lwaken/LwaCoin/3D/ANIM3_Moment.jpg

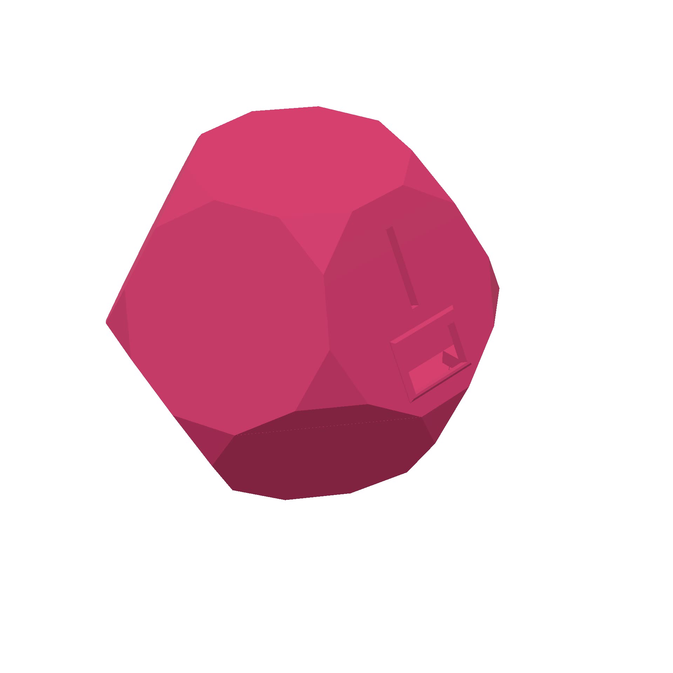
3D/ANIM3_Moment.jpg
