lwaken/LwaCoin/3D/atsdftgyh.png

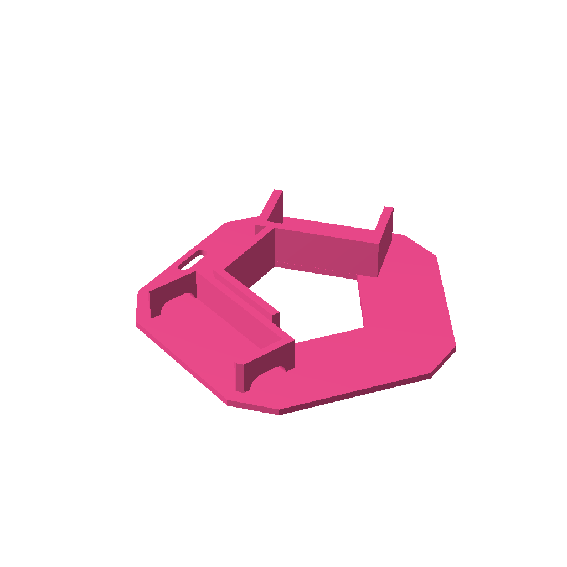
3D/atsdftgyh.png
