lwaken/LwaCoin/3D/Lower.png

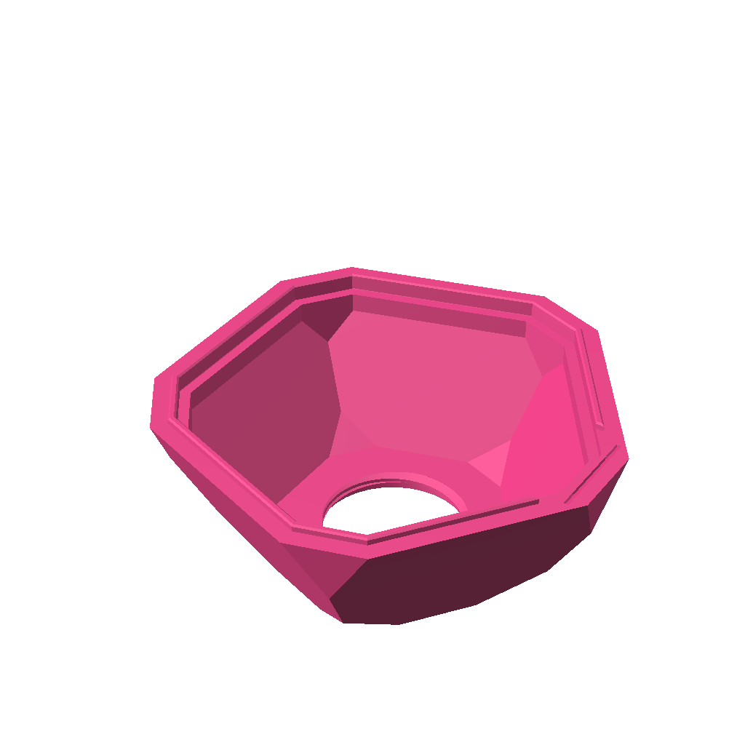
3D/Lower.png
