lwaken/LwaCoin/3D/New v6.png

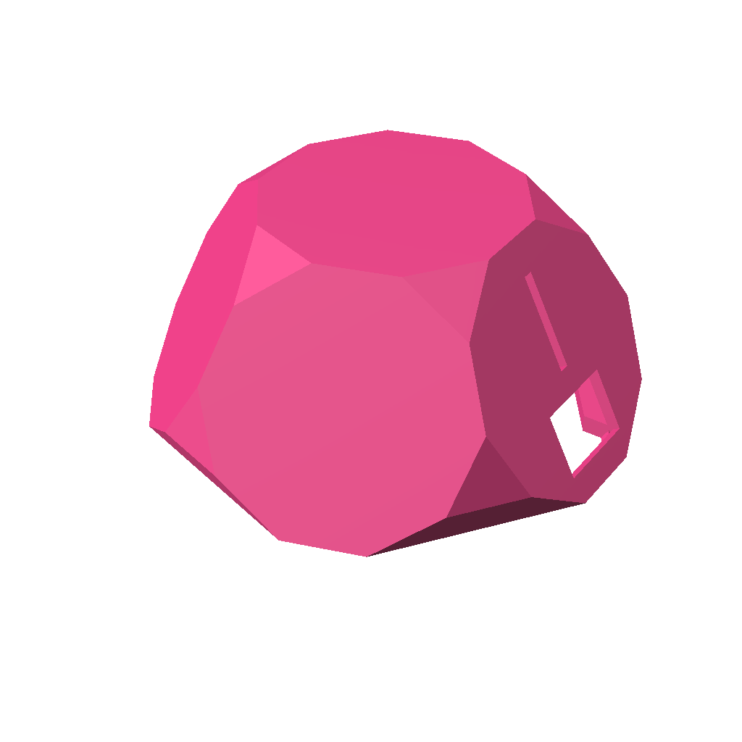
3D/New v6.png
