lwaken/LwaCoin/3D/New v2.obj

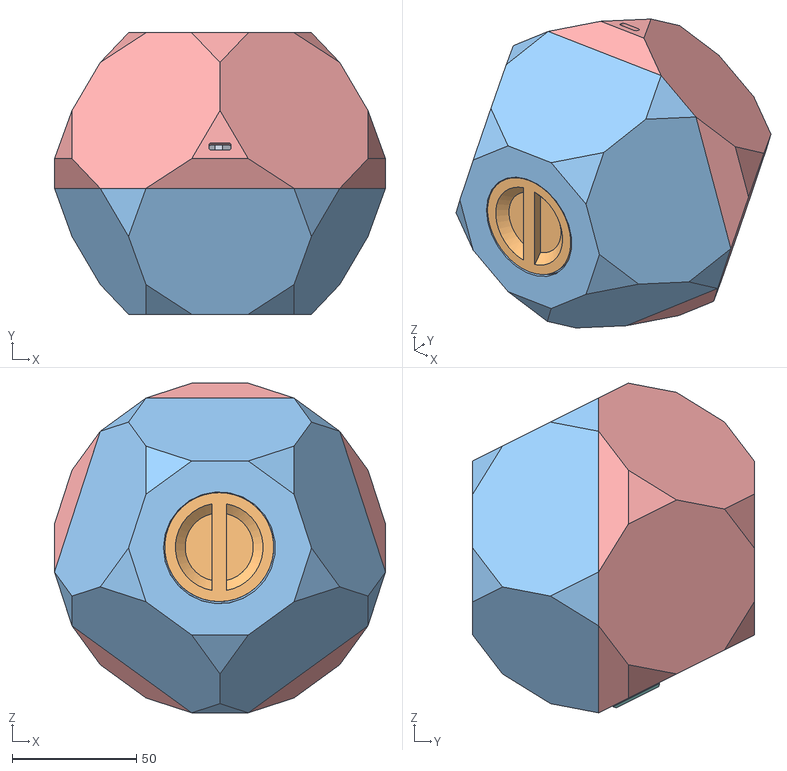
[picture p20: CAD file, 2021-02-12]
3D/New v2.obj
133.1 x 113.3 x 132.6
COin stuff
Lid
Lower body
inner body
Upper body
