lwaken/LwaCoin/3D/Lid.stl

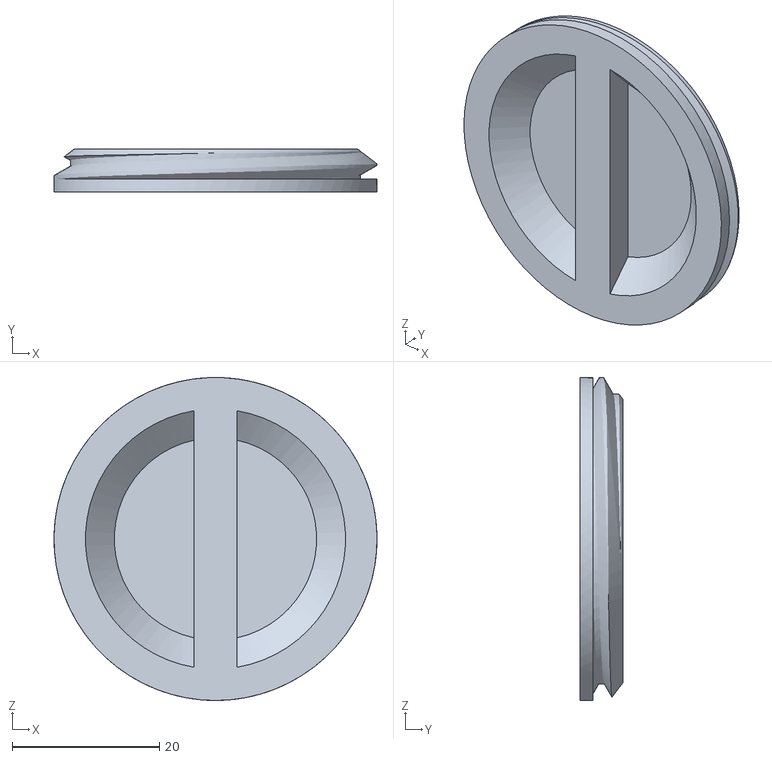
[picture p21: CAD file, 2021-02-12]
3D/Lid.stl
43.8 x 5.88 x 43.8
