lwaken/LwaCoin/3D/COin stuff.stl

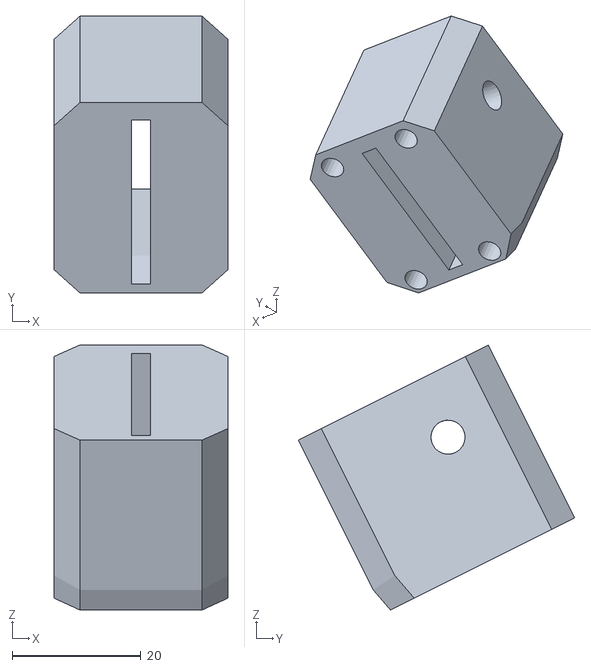
[picture p22: CAD file, 2021-02-12]
3D/COin stuff.stl
27.0 x 42.9 x 41.1
