lwaken/LwaCoin/3D/Body42.stl

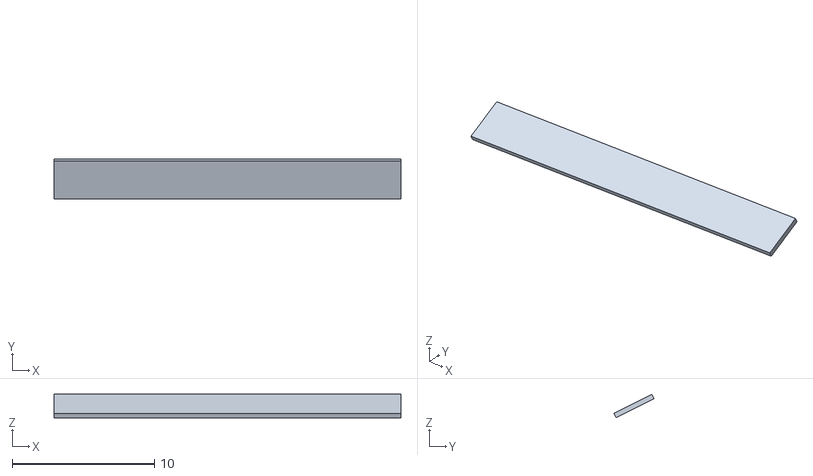
[picture p23: CAD file, 2021-02-12]
3D/Body42.stl
24.4 x 2.84 x 1.66
