lwaken/LwaCoin/3D/Body41.stl

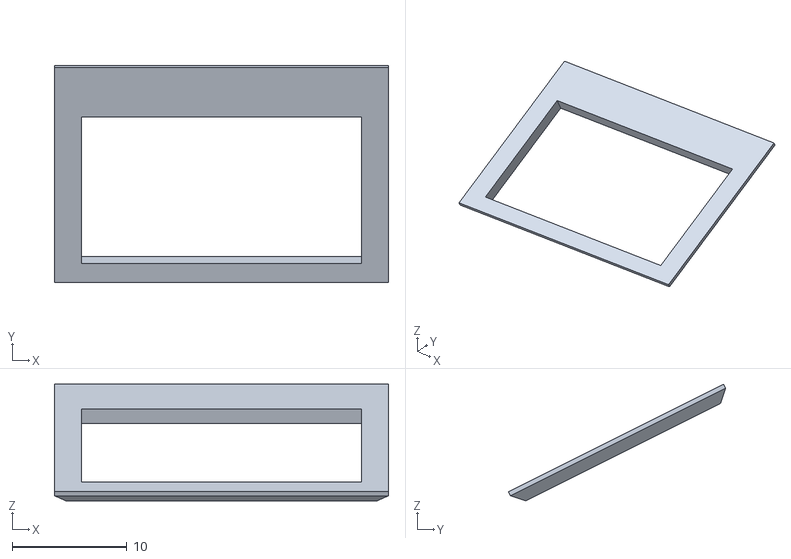
[picture p24: CAD file, 2021-02-12]
3D/Body41.stl
29.2 x 19.0 x 10.2
