lwaken/LwaCoin/(commit log)

2021-02-15 зкуыутефешщт
2021-02-16 зщзщзщ
